Capo01/odrive_based_electric_motor_dynamometer/(list of files, drawings)

Other design files:
Odrive motor testing procedure/Motor Data/Odrive D5065 270kv/Combined data.opj
