Capo01/odrive_based_electric_motor_dynamometer/Odrive motor testing procedure/Motor_efficiency_data_handler.xlsx

Sheet: input
15:06:01
Input voltage | Input current | Input Power | Test Motor Temperature | Test motor FET temp | Test motor q-axis current | Test motor d-axis current | Test motor Ibus | Test motor Ical | Output Torque | Output Speed | Output Speed set-point | Output Power | Absorber Motor Temperature | Absorber motor FET temp | Absorber q-axis current | Absorber d-axis current | Absorber Ibus | Absorber motor Ical
V | mA | W | Deg C | Deg C | A | A | A | A | N.mm | rad.s | rad.s | W | Deg C | Deg C | A | A | A | A
48.0980648 | 0 | 0 | 22.03667847 | 23.27824707 | -1.890558302 | 0.01547502205 | 0.02112060632 | 20 | -50.9 | -10.5077699 | 10.47197526 | 0.5544957851 | 19.01708258 | 21.37270718 | 0.08798586689 | 0.05361556485 | -0.0002767856276 | 20
48.09806442 | 0 | 0 | 21.02647397 | 23.11836586 | -3.683574176 | -0.06447274964 | 0.05144454949 | 20 | -113 | -10.34478444 | 10.47197526 | 1.171932729 | 23.42886542 | 21.42259979 | -0.9114934415 | -0.04916194603 | -0.009236164857 | 20
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
