Capo01/odrive_based_electric_motor_dynamometer/Odrive motor testing procedure/Motor Data/Odrive D5065 270kv/Data fitting.xlsx

Sheet: Sheet1
For exp data
Speed | RPM | 3000
Torque | N.m | 1
Efficiency |  | 75.32524969
 | Speed | Speed | Speed | Speed | Speed | Speed | Speed | Speed | Speed | Speed | Speed | Speed | Speed | Speed | Speed | Speed | Speed | Speed | Speed | Speed | Speed | Speed | Speed | Speed | Speed | Speed | Speed | Speed | Speed | Speed | Speed | Speed | Speed | Speed | Speed | Speed | Speed | Speed | Speed | Speed | Speed
Torque | RPM | RPM | RPM | RPM | RPM | RPM | RPM | RPM | RPM | RPM | RPM | RPM | RPM | RPM | RPM | RPM | RPM | RPM | RPM | RPM | RPM | RPM | RPM | RPM | RPM | RPM | RPM | RPM | RPM | RPM | RPM | RPM | RPM | RPM | RPM | RPM | RPM | RPM | RPM | RPM | RPM
N.m | 0 | 100 | 200 | 300 | 400 | 500 | 600 | 700 | 800 | 900 | 1000 | 1100 | 1200 | 1300 | 1400 | 1500 | 1600 | 1700 | 1800 | 1900 | 2000 | 2100 | 2200 | 2300 | 2400 | 2500 | 2600 | 2700 | 2800 | 2900 | 3000 | 3100 | 3200 | 3300 | 3400 | 3500 | 3600 | 3700 | 3800 | 3900 | 4000
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
