Capo01/odrive_based_electric_motor_dynamometer/Odrive motor testing procedure/Motor Data/Odrive D5065 270kv/Motor_efficiency_data_handler.xlsx

Sheet: input
Input voltage | Input current | Input Power | Test Motor Temperature | Test motor FET temp | Test motor q-axis current | Test motor d-axis current | Test motor Ibus | Test motor Ical | Output Torque | Output Speed | Output Speed set-point | Output Power | Absorber Motor Temperature | Absorber motor FET temp | Absorber q-axis current | Absorber d-axis current | Absorber Ibus | Absorber motor Ical
V | mA | W | Deg C | Deg C | A | A | A | A | N.mm | rad.s | rad.s | W | Deg C | Deg C | A | A | A | A
48.10418739 | 0 | 0 | 25.46176033 | 21.19194641 | -1.595489633 | 0.04020214006 | 0.01838459847 | 20 | -15.2 | -10.5748814 | 10.47197526 | 0.1530337779 | 23.03992856 | 23.05896282 | -0.06308612674 | -0.0005359254777 | 0.001125372985 | 20
48.09959526 | 0 | 0 | 25.0270949 | 21.07633514 | -7.25233469 | -0.02707521282 | 0.1357123017 | 20 | -191.5 | -10.3160223 | 10.47197526 | 1.973303587 | 22.85214868 | 23.38942928 | -2.887152982 | -0.01645785756 | -0.01407346465 | 20
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
