Capo01/odrive_based_electric_motor_dynamometer/(commit log)

2019-04-28 Odrive motor testing procedure
2019-04-28 Required Arduino libraries and load cell reading sketch
2019-05-04 bugfixes and test motor efficiency test added
    [motor_param.csv, odrive_data.csv]
2019-05-05 Bugfixes
    Updated motor efficiency test
    [Motor_efficiency_data_handler.xlsx, odrive_data.csv]
2019-05-05 allowed odrive axis to be changed
    Odrive axis can now be specified in parameter file.
    [odrive_data.csv]
2019-05-05 Updated efficiency test for smooth vel and current changes
    [Motor_efficiency_data_handler.xlsx, odrive_data.csv]
2019-05-11 Updated efficiency test and D5065 data
    [Combined data.opj, Motor_efficiency_data_handler.xlsx, odrive_data.csv]
2019-05-12 cleaned up motor data
    [Combined data.opj, Motor_efficiency_data_handler.xlsx]
2019-05-12 data analysis
    [Combined data.opj, Data fitting.xlsx, Motor_efficiency_data_handler.xlsx]
